edwardsb/LPDR/README.md

LPDR
====

Arduino Low Power Data Reporter via GSM Cellular Communication
