edwardsb/LPDR/MegaExecOperation.docx

Features:

  - Program development utilitizes:
    - Arduino IDE
      - See C:\Users\Bob\Documents\GitHub\LPDR\DataReporter_REV_1_1\ DataReporter_REV_1_1.ino
      - Atmel Studio 6
      - Includes all source editing and debug features.
      - See C:\Users\Bob\Documents\GitHub\LPDR\DataReporter_REV_1_1\DataReporter_REV_1_1.atsln
    - Visual Studio 2012
      - Includes all source editing and debug features.
      - See C:\Users\Bob\Documents\GitHub\LPDR\DataReporter_REV_1_1\DataReporter_REV_1_1.sln
  - The executive sleeps the processor only if:
    - All tasks concurs that the sleep mode may be entered.
    - Once the sleep mode is entered the processor remains asleep until:
      - The watchdog intgerrupt is received.
      - Any of the 3 ATmega2560 external interrupts, if enabled, is received.
  - Thread execution time is determined only by the threads, i.e. “niceness” may be determined by each thread in each of the individual threads’ states.
  - Each thread individually determins if the executive is allowed to sleep the processor.
  - All datapoints are buffered in SD memory until delivery to the remote database is accomplished.
  - Shared executive tasks, e.g. SD read/writes, RTC read/writes, System Log writes, etc., are all queued, are controlled by and communicate via structures.

Figure 1 is a block diagram depicting the basic operation of the ME (Mega Executive). The ME is intended as an extremely rudimentary thread or task execution environment designed primarily for a Li-Ion battery power MPU (Sparkfun Mega Pro) system with solar power replenishment.

The basic operation begins immediately after “RESET”ing the MPU and the execution of the Arduino IDE’s required setup() function in the DataReporter_REV_n_n.ino source file.

The thread execution is mechanized by the code in the loop() function in the DataReporter_REV_n_n.ino source file. The “for” statement block in loop(), represented by the roterary switch in the Figure 2, executes thereafter at all times that the MPU is not “sleeping” (Power Management and SleepModes).

The figure is intended to show that all threads, a.k.a. tasks or state machines, execute as long as their respective series switch is closed and the MPU is not sleeping. Note that the MPU Is normally in the Power-Down mode waking up to full operation and at least one pass through the “for” block once each 8 seconds.

The series switch is mechanized as a global array of boolean flags. True equals call-the-thread function and false equals don’t-call-the-thread function.

The roterary switch is mechanized as an array of pointers to the thread functions. The threads are mechanized as a function having no arguments, returning a void and containing a switch statement whose argument is the current executing thread state of the thread. The thread state is held in a global array of integers the state is generally controlled by the associated state machine itself. Note that due to the global scope of the execuitive variables any thread may schedule and monitor any other thread.

Global, as used here, is the address space shared by the executive and all threads. All variables belonging exclusively to the threads, and referenced only by other states of the same thread are defined as static in the thread function.

To use the ME in an embedded application it is intended that you use the core set of threads and functions augmented by your specialized threads and functions added to taylor the ME to mechanize your application’s unique requirements. Some of the core threads may also have to be changed to provide further tayloring for your application’s unique requirements.

The core threads and functions are:

- setup() (Arduino requirement)
- loop() (Arduino requirement)
- *ConsoleTask()
- *MonitorTask()
- *ResourceQueues
  - Write System Log
  - RTC
  - SD Card
  - GPRS Operations
  - Data Logging
- *GprsOperations()
- *RtcTask()
- *SdReadWriteTask()
- *Setup()
- *SystemLogTask()
- ModemSimulation()
  - Diagnostic only.
- *DataLog()
- ReportData()
- TaskTemTask()

The ConsoleTask() thread is provided as a development tool to allow the Arduino’s IDE’s Serial Monitor to interface the ME via the USB-RS232 FTDE cable. The Console thread allows serial input from the IDE’s Serial Monitor to be parsed and interact with the ME threads, e.g. it is possible to set the RTC through the IDE’s Serial Monitor.

The console task is scheduled whenever a character is received from the IDE and the console task is not already scheduled. When the IDE sends a character via the serial input the leading edge of the “Start Bit” wakes up the mpu via an external interrupt, sets a flag, detaches the interrupt and when the MonitorTask begins to execute after waking up it schedules the ConsoleTask() and disables further sleep periods. At the completion of the console operation the console task reattaches the interrupt.

See the Console thread’s existing command parser for examples of interacting with the ME through the IDE’s Serial Monitor.

The MonitorTask() thread must be unconditionally scheduled at all times. The Monitor thread’s primary functions are:

- Maintain the MPU in the lowest possible current draw mode.
  - Sleep only if all threads indicate “sleep is don’t care for this associated thread”.
    - Mechanized as a global integer/long containing 16/32 bit flags.
- Wake up for any of the following interrupts:
  - Bucket tipped.
    - #define EXT_INTERRUPT_0 0
    - If bucket tip signal is LOW.
    - The MPU’s External Interrupt 4, Port E Pin 4 is wired to the MPU's pin marked PWM 2. This is the Arduino's Digital Pin 2 and is also Arduino's External Interrupt 0. This is the DataReporter's Bucket Tipped interrupt.
  - Watchdog timer. (≈ 9 secs.)
  - IDE console-input-character-to-be-received interrupt.
      - EXT_INTERRUPT_1 1
      - The MPU’s External Interrupt 5, Port E Pin 5 is wired to the MPU's pin marked PWM 3. This is the Arduino's Digital Pin 3 and is also Arduino's External Interrupt 1. This external interrupt is tied to the MPU's pin marked RX0<-0. RX0 is the Arduino IDE's serial transmit signal.
- Schedule other threads as required when the MPU wakes up.

The resource queues provide a means to coordinate the use of shared resources by the various tasks performed by the DataReporter tasks. The shared resources are identified in the list of core threads/tasks and functions above. All shared resources are used in the following manner:

- Fill out an associated resource control-communicate structure.
- Turn off interrupts.
- Push a pointer, to your structure, onto the associated resource’s queue.
  - Starts associated resource’s thread/task if not already scheduled.
- Turn the interrupts on.
- Monitor flags in the structure for status.

The SdReadWriteTask()

See the associated structure definitions for detains.

The GprsOperations() mechanizes the shared GPRS modem resource. Client tasks queue for the use of the modem the same as any other ME shared resource. The GPRS operations task (GprsOperations()) functions to turn power onto the modem, register with the GSM network, connect to a internet server and safetly turn power off the modem. Data interchanges with the server are handled directly by a client task once it has established ownership of the modem resource. The steps for capturing and using the modem are as follows:

Initialize your modemControl structure:

gprsStatus GPRS_POWER_OFF.

clientStatus CLIENT_WAIT.

Interrupts off.

Push your modemControl structure.

Interrupts on.

Wait for gprsStatus to indicate GPRS_DATA_EXCHANGE or GPRS_OPERATION_ERROR.

If GPRS_DATA_EXCHANGE then

Use the Serial1 objet to communicate with the indicated server.

When the server interchange is complete set the clientStatus to CLIENT_DONE.

The GprsOperation task will:

Close the internet connection.

Power down the modem.

Check the queue for the next client.

or GPRS_OPERATION_ERROR

The GprsOperation has reported the error in the System log and waited for the system log to be written.

GPRS_WAIT_AFTER_ERR

TASK_INIT_STATE No power down then check queue.

Disconnected from the internet.

Powered down the modem.

The client should try later.

Do not issue the +++ (Leave the Data Mode) AT command or use the 3 character “+++” sequence in any data sent to the server. The maximum time that the modem may be captured by any ME threads is 15 minutes.

The RtcTask() thread mechanizes the DSS3234 real time clock IC shared resource. It provides the following RTC operations:

- Set the RTC date and time.
- Read the RTC’s date and time.
- Increment the RTC’s time one second. (Not coded)
- Decrement the RTC’s time one secod. (Not coded)
- Set the RTC’s Alarm1. (Not coded)
- Set the RTC’s Alarm1. (Not coded)

The SdReadWriteTask() mechanizes the shared SD card resource. It provides the following RTC operations:

- SD Read (Not coded)
- SD Write. (Not coded)

The Setup() function is called one time after MPU reset and provides the following initialization operations:

- MPU General Purpose I/O signal setup and initialization:
  - Solar regulator enable/disable.
  - Xbee reset.
  - Xbee power good.
  - Battery manager power not good
  - Battery manager status 1
  - Battery manager status 2
  - RTC SPI slave select.
  - SD Card SPI slave select.
  - Task scheduling variables:
    - DATA_LOGGER_TASK
    - DATA_REOPORT_TASK
    - SYSTEMLOG_TASK
    - RTC_TASK
    - SDRW_TASK
    - MONITOR_TASK
    - GPRS_TASK
    - CONSOLE_TASK
    - MDMSIM_TASK
  - Keep awake flags.
  - Schedule the monitor task.
  - Initialize the SD Card.
  - Make an entry in the System log to indicate the MPU reset.
  - Open the data history file for this month.
  - Initialize the datapoint queueing files.
  - Initialize the datapoint queueing variables.

The SystemLogTask() mechanizes the shared system message logging task. The system log task provides a means for other DataReporter task to log errors or important events along with the date and time.

The DataLog() task mechanizes the shared data datapoint logging task. Datapoints asynchronously collected by the DataReporter are temporarly stored in two “flip-flop“ SD card files until they can be permanately written to the cloud data base. This task is not coded.

The ReportData() task writes any queued datapoints to the cloud database. This ask is not coded.

The TaskTemTask() is simply template source code and instructions intended to be used to add additional tasks.

There are 4 Arudino A/D channels as follows:

- #define SOLAR_OUTPUT_MONITOR 0
  - This is the output of the solar panel.
- #define BATTERY_MONITOR 1
  - This is the output of the Li-Ion battery
- #define RFEGULATOR_MONITOR 2
  - This is the output of the 5 VDC Buck Regulator (KA278R05)
- #define LOAD_MONITOR 3

Thia is the output of the Li-Ion Battery Charger Power Manager (MCP73871)

Processor Control

State 1

State 2

State n

Thread 1

State 1

State 2

State n

Thread 2

State 1

State 2

State n

Thread n

Figure 1

Mega Executive Block Diagram

Figure 1

DataReporter Hardware Block Diagram

Figure 2

DataReporter Hardware Block Diagram

SD Card (BOB-1140)

Solar Panel

Li-Ion Battery Charger Power Manager (MCP73871)

Li-Ion Battery

A/D Monitor (BATTERY_MONITOR)

2.5 VDC Voltage Reference (REF192)

5 VDC Boost-Buck Regulator (S7V7F5)

3.3 VDC Boost Buck Regulator (REG710)

Charge

Load

A/D Monitor

(LOAD_MONITOR)

Three Digital Inputs (BATTERY_MNGR_PGNOT BATTERY_MNGR_STAT2BATTBATTERY_MNGR_STAT1_LBO)

AREF

Arduino IDE Interface Sparkfun (DEV-09873)

External Interrupt (CONSOLE_ACTIVE)

External Interrupt (BUCKET_TIP)

Real Time Clock (DS3234)

SPI Bus

AREF

Xbee

Coordinator

3.3 VDC Buck Regulator

Cellular Shield

Antenna

3.3 VDC Buck Regulator

Power (VCC)

ATmega2560 General Purpose

Digital Input

ATmega2560 General Purpose I/O

ATmega2560 External Interrupt

ATmega2560 A/D Channel Voltage Monitoring Point

Digital Output (XBEE_REG_ENABLE)

Digital Output (CELLURE_REG_ENABLE)

DataReporter Controller Arduino Mega PRO (ATmega2560)

Antenna

5VDC Solar Regulator (KA278R05)

Solar Panel

A/D Monitor (RFEGULATOR_MONITOR)

A/D Monitor (SOLAR_OUTPUT_MONITOR)

Digital Output (SOLAR_REG_ENABLE)

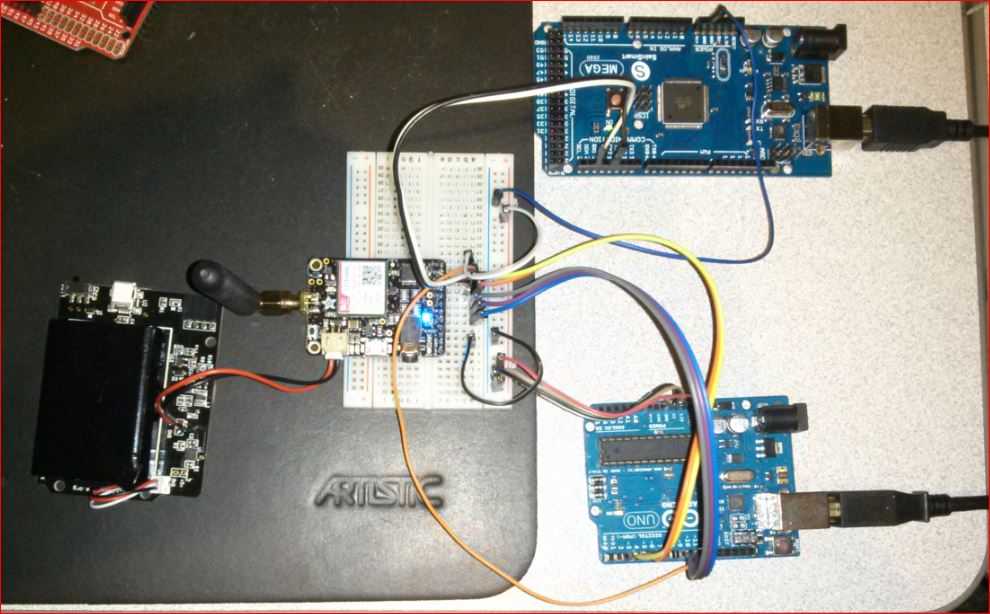
[picture p7: figure]
