edwardsb/LPDR/DataReporter_REV_1_1/TaskTemplate.ino

//
// Task description...
//

#include "Definitions.h"

//
// Local definitions go here.
//
#define TT_STATE_1    1
#define TT_STATE_2    2
//
// Local globals go here.
//

// Enter here only from the exec.
void TaskTemTask(void)      
{
  switch(tasksState[TEMPLATE_TASK])
  {
    case TASK_INIT_STATE:
    
    break;
    
    case TT_STATE_1:
    
    break;
    
    case TT_STATE_2:
    
    break;
    
    default:
    
    break;
  }
  
}
