edwardsb/LPDR/DataReporter_REV_1_1/ModemSim.h

//
// This task is for simulating the modem's current load
// on the DataReporter's battery.
//

#include "Definitions.h"


#define BATTERY_LOG_FILE 
// A GSM burst has 114 bits of information.
#define MDMSIM_GSM_BITS_PER_BURST        114
// Number of bits in a digital packet.
#define MDMSIM_PDU_BITS_PER_BURST        456
// Number 
// Payload
#define MDMSIM_
#define MDMSIM_
#define MDMSIM_
#define MDMSIM_
#define MDMSIM_
#define MDMSIM_
#define MDMSIM_
#define MDMSIM_

// The number of characters in a report.
#define MDMSIM_CHARS_IN_A_REPORT      1000
// A burst lasts for 0.577 mSec.
// The number of characters sent in a normal burst        
#define MDMSIM_NO_OF_CHARS        14
// The number of 0.577 mS slots in a frame once
// each 4.615 mS.
#define MDMSIM_SLOTS_IN_A_FRAME    8
