edwardsb/LPDR/(commit log)

2013-09-14 adding initial arduino file directory to git
2013-09-22 modified: DataReporterRequirements_1_2.docx Add simulated modem power control. Add General requirements.
